tungstenexe/Tungsten-V2/img/Tungsten_V2.JPG

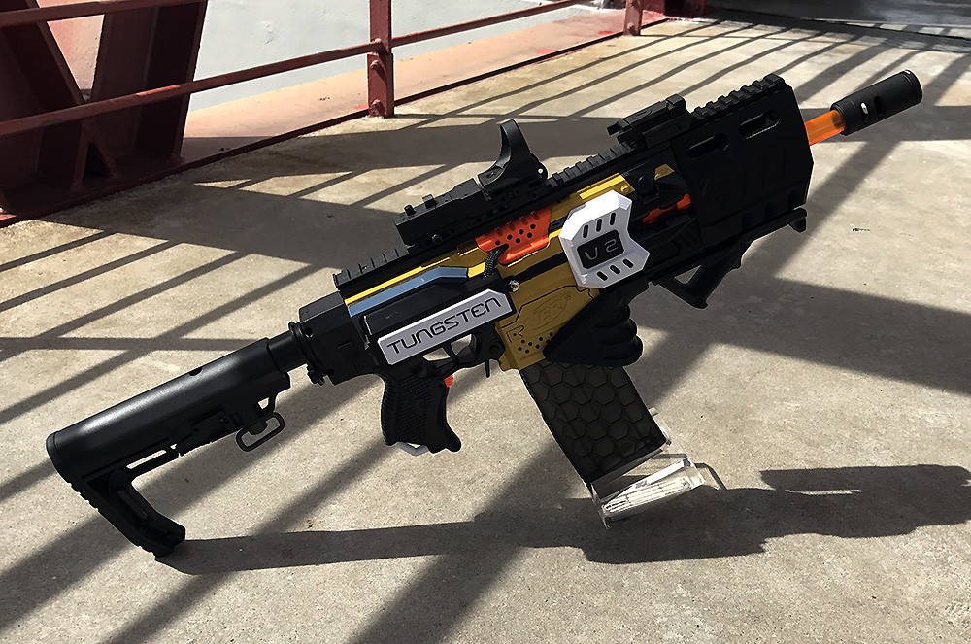
img/Tungsten_V2.JPG
