tungstenexe/Tungsten-V2/circuit/readme.txt

ESC set jumper to have F/B and use Lipo

Disclaimer:
Please note these diagrams are how I implement 
my own blaster built.
 
Do take caution when modding your blaster, 
as I take no responsibility on your modding 
implementation of the circuits shown.
