tungstenexe/Tungsten-V2/ItemsList.docx

Below are the items I made use of for the build, I did not include the normal switches and buttons, wires.

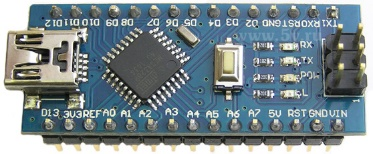
[picture p2: figure]

| Arduino Nano | https://world.taobao.com/item/42296011350.htm?fromSite=main&spm=a312a.7700846.0.0.tO8EAg&_u=81p5mvl5c6fe

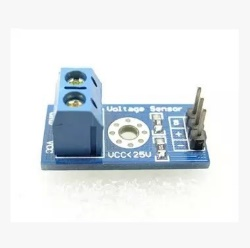
[picture p3: figure]

| Voltage sensor module (to find current voltage of lipo to make calculation of ROF voltage) | https://world.taobao.com/item/43100493066.htm?fromSite=main&spm=a312a.7700846.0.0.tO8EAg&_u=81p5mvl5a29b

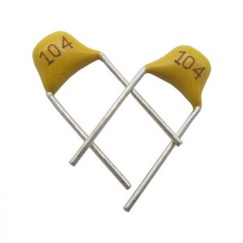
[picture p4: figure]

| 104 Capacitor 104P 0.1UF 100NF 50V (to filter electric noise produced by DC motors) | https://detail.tmall.com/item.htm?id=41231794779&toSite=main

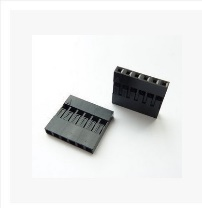
[picture p5: figure]

| DuPont head | https://item.taobao.com/item.htm?spm=a1z0d.6639537.1997196601.117.91b1f81zPnNkX&id=39573216513

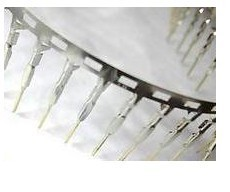
[picture p6: figure]

| DuPont male head | https://world.taobao.com/item/19134756118.htm?fromSite=main&spm=a312a.7700846.0.0.eysEMU&_u=n1p5mvl5d7cb

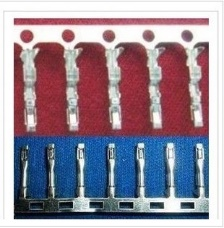
[picture p7: figure]

| DuPont male head | https://world.taobao.com/item/37120521950.htm?fromSite=main&spm=a312a.7700846.0.0.eysEMU&_u=n1p5mvl51604

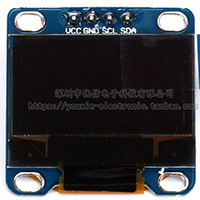
[picture p8: figure]

| Yellow + blue OLED display | https://item.taobao.com/item.htm?spm=a1z09.2.0.0.2ed6e797vXDadE&id=524195193806&_u=51p5mvl5f789

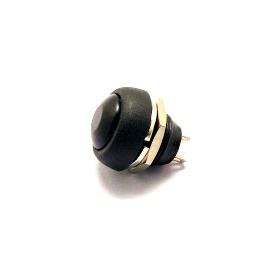
[picture p9: figure]

| Button | https://world.taobao.com/item/537772544456.htm?fromSite=main&spm=a312a.7700846.0.0.eysEMU&_u=n1p5mvl5c95a

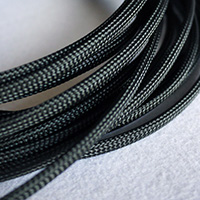
[picture p10: figure]

| Wire net | https://item.taobao.com/item.htm?spm=a1z09.2.0.0.2ed6e7977udndZ&id=546470586881&_u=51p5mvl56b96

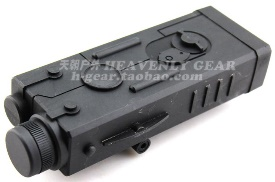
[picture p11: figure]

| Big battery case | https://item.taobao.com/item.htm?spm=a1z09.2.0.0.2ed6e7977udndZ&id=38506953674&_u=51p5mvl5610a

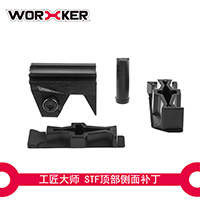
[picture p12: figure]

| Worker cosmetic kit | https://item.taobao.com/item.htm?spm=a1z09.2.0.0.2ed6e797XsdCh0&id=523857592612&_u=61p5mvl5e549
| Worker cosmetic kit | https://item.taobao.com/item.htm?spm=a1z09.2.0.0.2ed6e797XsdCh0&id=40420088470&_u=61p5mvl59a8f

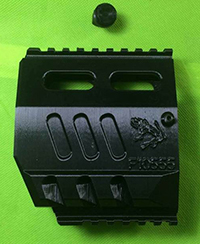
[picture p13: figure]

| Worker cosmetic kit | https://item.taobao.com/item.htm?spm=a1z09.2.0.0.2ed6e797XsdCh0&id=520867765476&_u=61p5mvl5f9ee

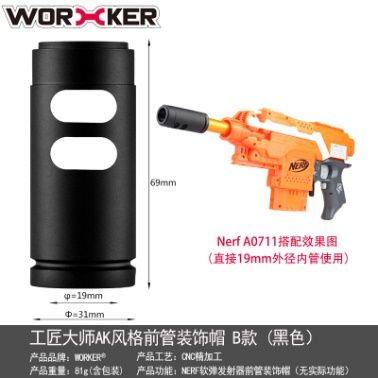
[picture p14: figure]

| Worker cosmetic kit | https://item.taobao.com/item.htm?id=556106349949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 (https://item.taobao.com/item.htm?id=556106349949)

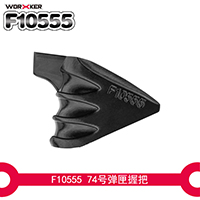
[picture p15: figure]

| Worker cosmetic kit | https://item.taobao.com/item.htm?spm=a1z09.2.0.0.2ed6e797XsdCh0&id=522103785710&_u=61p5mvl5143c

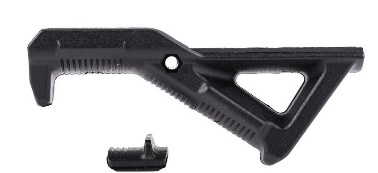
[picture p16: figure]

| Grip | https://item.taobao.com/item.htm?spm=a1z0d.7625083.1998302264.6.7e0ce5fbr6sPRc&id=530326323563

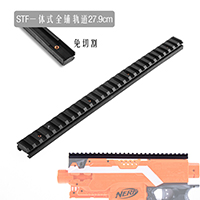
[picture p17: figure]
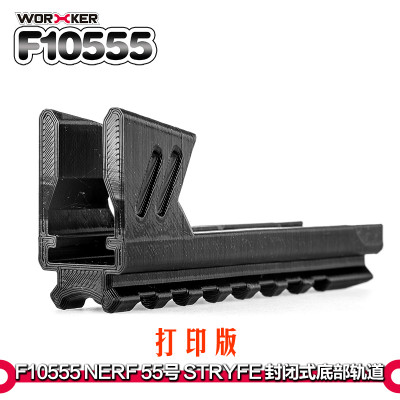
[picture p18: figure]

| Worker cosmetic kit | https://item.taobao.com/item.htm?spm=a1z09.2.0.0.2ed6e797XsdCh0&id=520101702790&_u=61p5mvl5c578

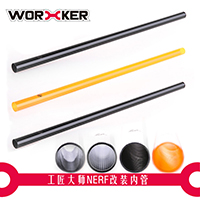
[picture p19: figure]

| 20cm barrel | https://item.taobao.com/item.htm?spm=a1z09.2.0.0.2ed6e797XsdCh0&id=542111980772&_u=61p5mvl55610

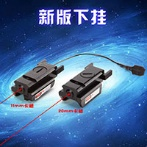
[picture p20: figure]

| | https://item.taobao.com/item.htm?spm=a1z09.2.0.0.2ed6e797XsdCh0&id=523949251644&_u=61p5mvl53e14

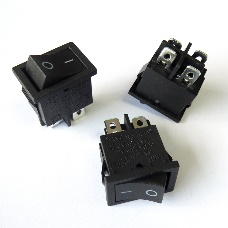
[picture p21: figure]

| 4 legs switch | https://item.taobao.com/item.htm?spm=a1z09.2.0.0.2ed6e797XsdCh0&id=541605000895&_u=61p5mvl5ef70

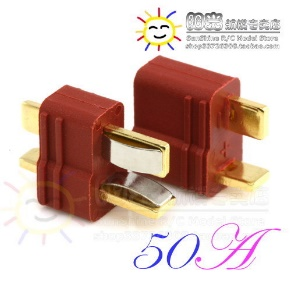
[picture p22: figure]

| Dean connector | https://world.taobao.com/item/2003313604.htm?fromSite=main&spm=a312a.7700846.0.0.eysEMU&_u=n1p5mvl55a26
| Battery Tape | https://hobbyking.com/en_us/battery-tape-150mm-5pcs-bag.html

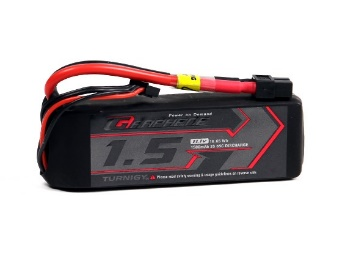
[picture p23: figure]

| Turnigy Graphene 1500mAh 3S 65C LiPo Pack W/ XT60 | https://hobbyking.com/en_us/graphene-1500mah-3s-65c-w-xt60.html

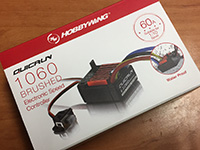
[picture p24: figure]

| Hobbywing 1060 Brushed ESC | Cannot find link

I was unable to locate some of the seller for some items, they seems to have stop selling the items.

There are more basic items such as pin connectors, etc.

Article on Dealing with Motor Noise:

https://www.pololu.com/docs/0J15/9

Other Useful Tools

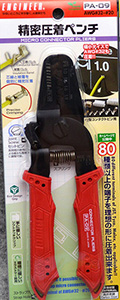
[picture p25: figure]

| Crimper - engineer PA-90 | https://world.taobao.com/item/9117898770.htm?fromSite=main&_u=t2dmg8j26111
