tungstenexe/Tungsten-V2/circuit/00_MainOverall.jpg

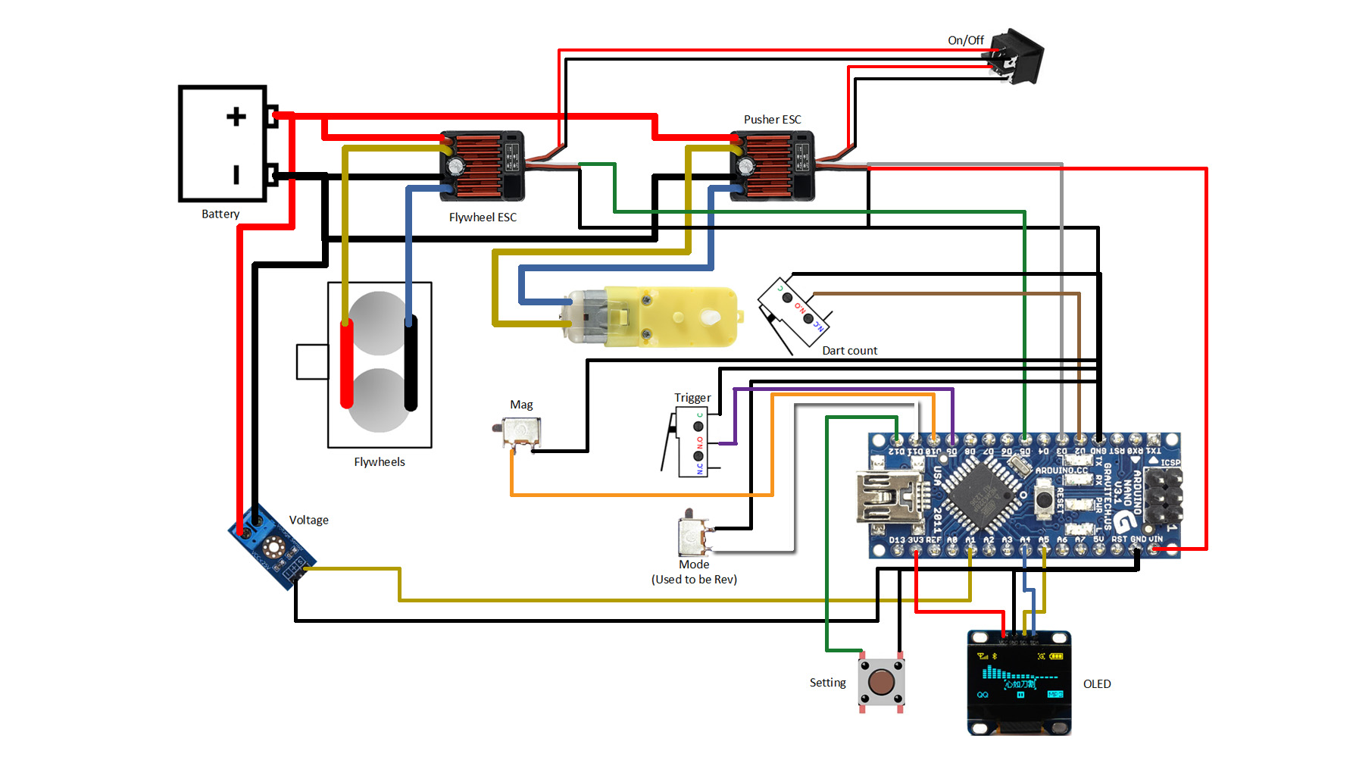
circuit/00_MainOverall.jpg
