tungstenexe/Tungsten-V2/circuit/01_ESC_Battery.jpg

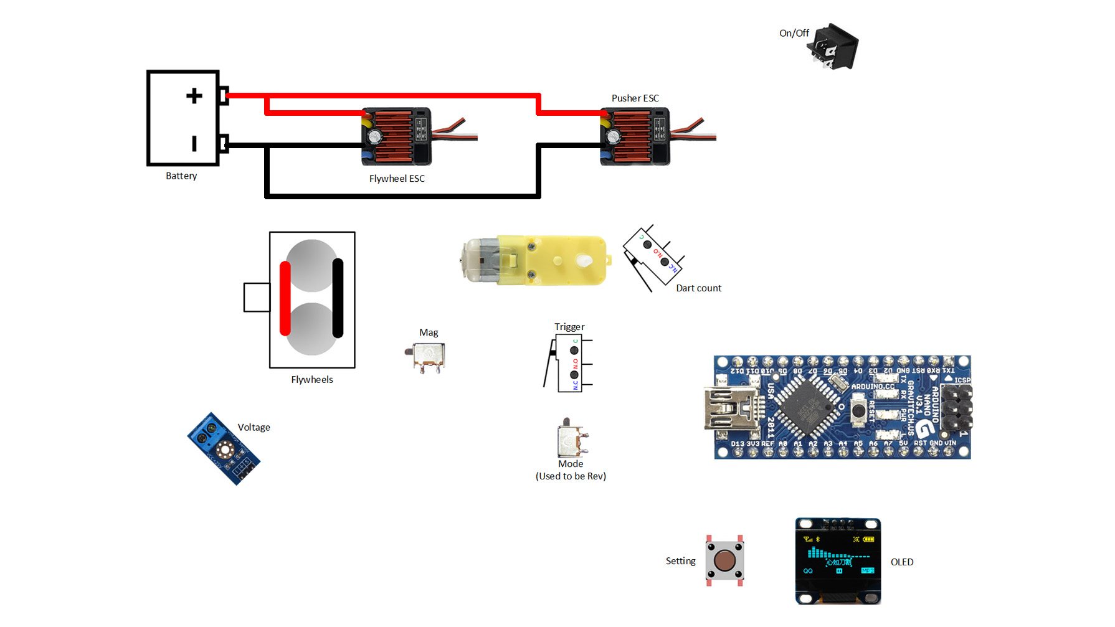
circuit/01_ESC_Battery.jpg
