tungstenexe/Tungsten-V2/circuit/02_ESC_OnOff.jpg

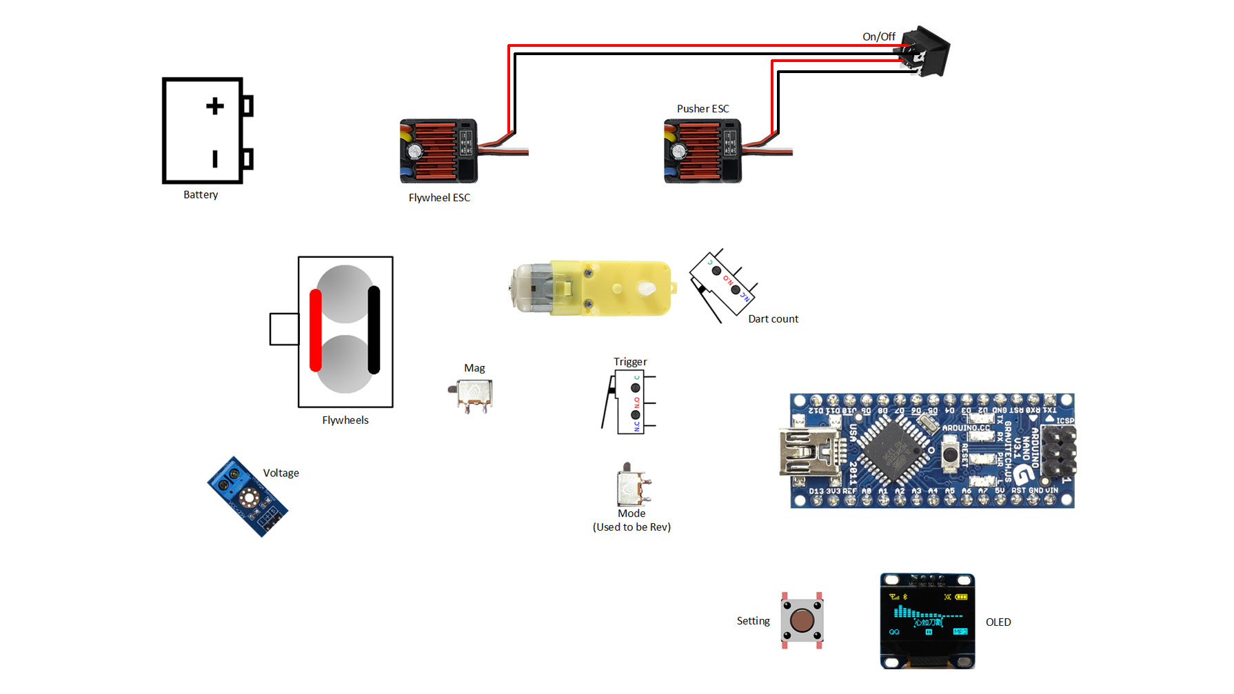
circuit/02_ESC_OnOff.jpg
