tungstenexe/Tungsten-V2/circuit/04_ESC_ControlAndVin.jpg

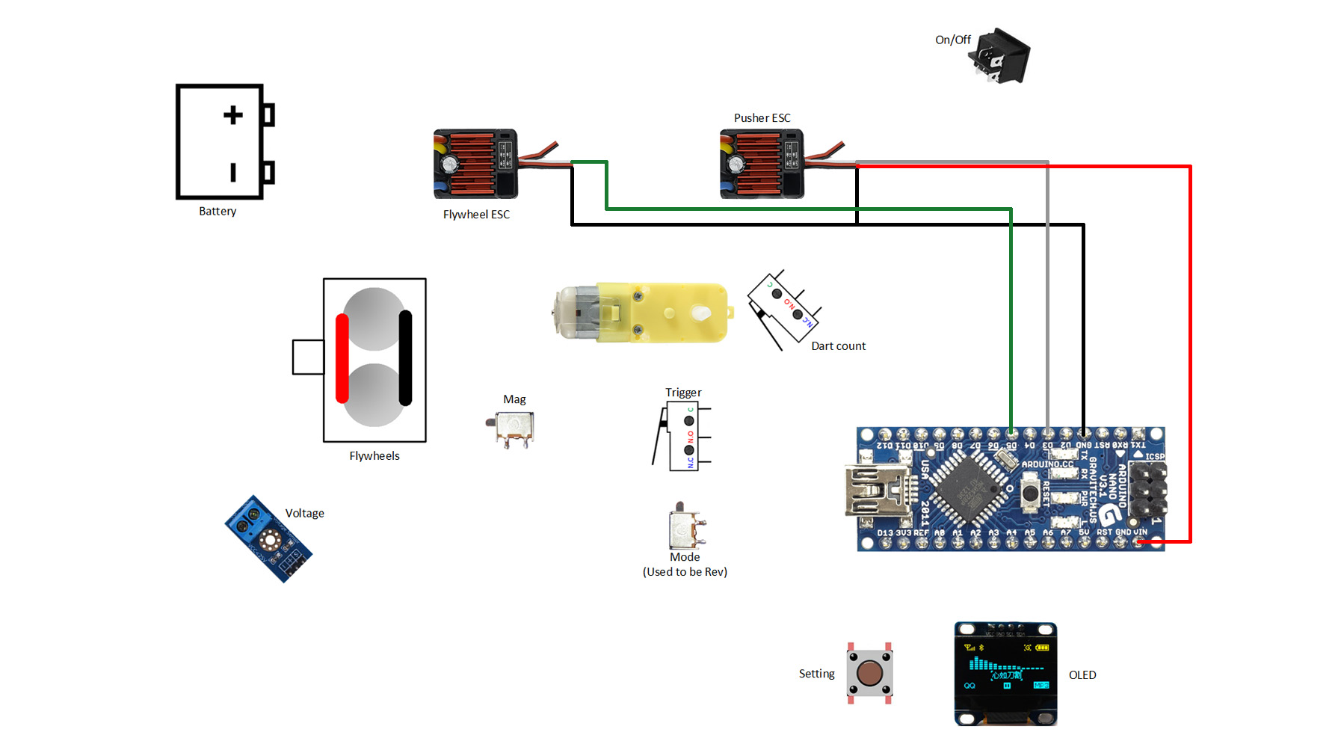
circuit/04_ESC_ControlAndVin.jpg
