tungstenexe/Tungsten-V2/circuit/05_ESC_Overall.jpg

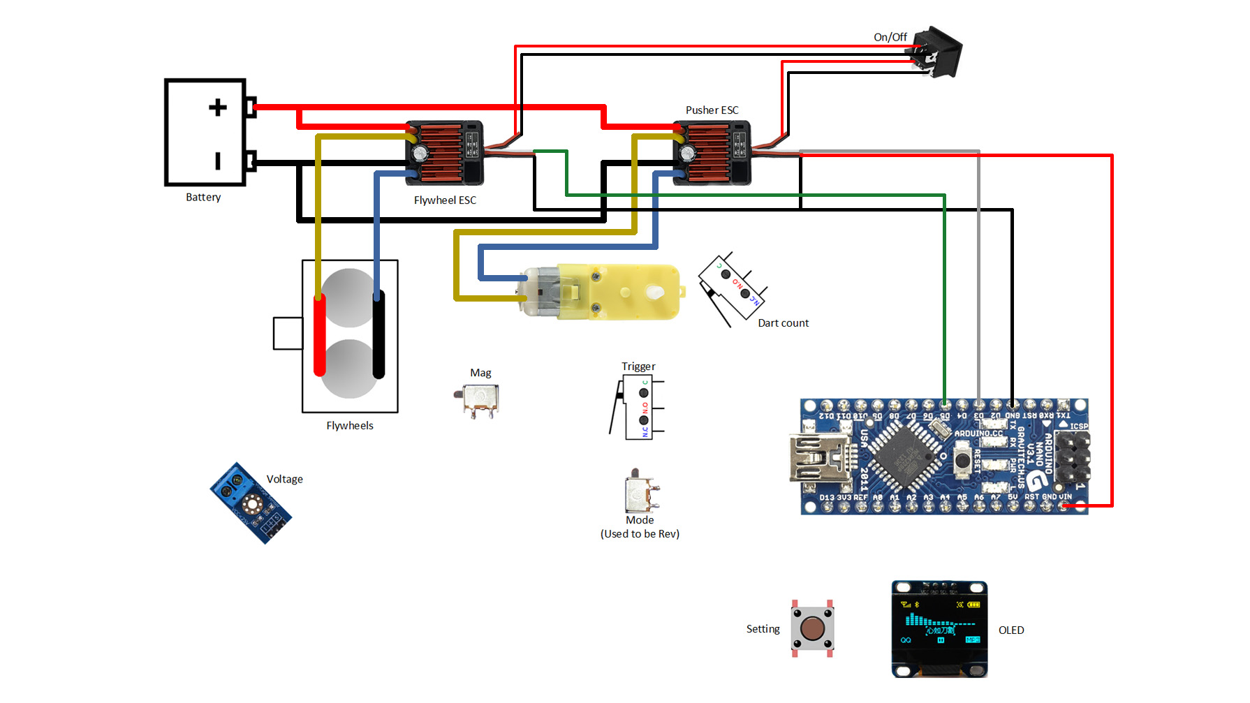
circuit/05_ESC_Overall.jpg
