tungstenexe/Tungsten-V2/circuit/06_VoltageSensor.jpg

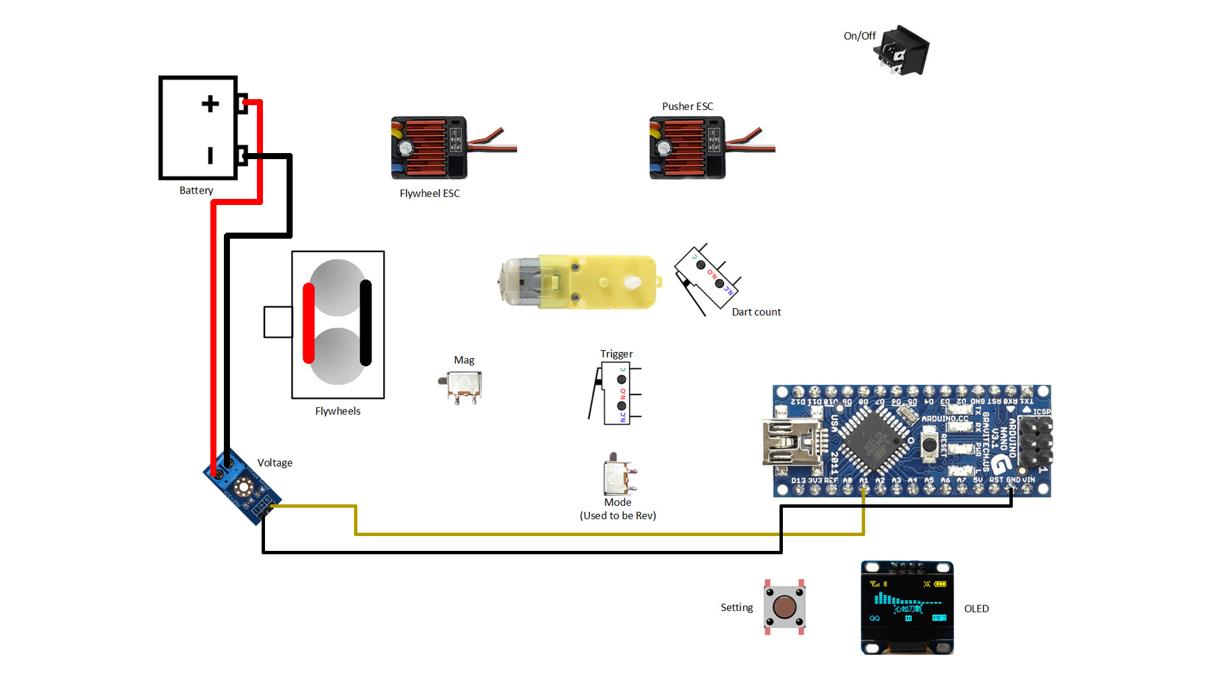
circuit/06_VoltageSensor.jpg
