tungstenexe/Tungsten-V2/circuit/07_DartCounter.jpg

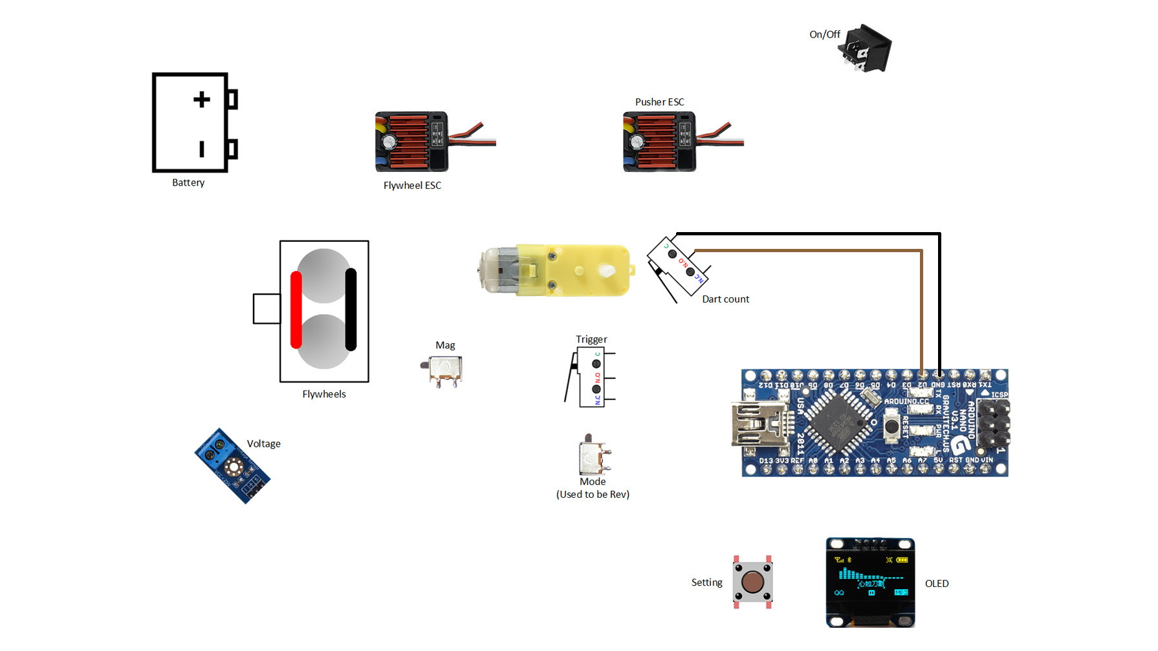
circuit/07_DartCounter.jpg
