tungstenexe/Tungsten-V2/stl/oledButtonHousingPart_B.stl

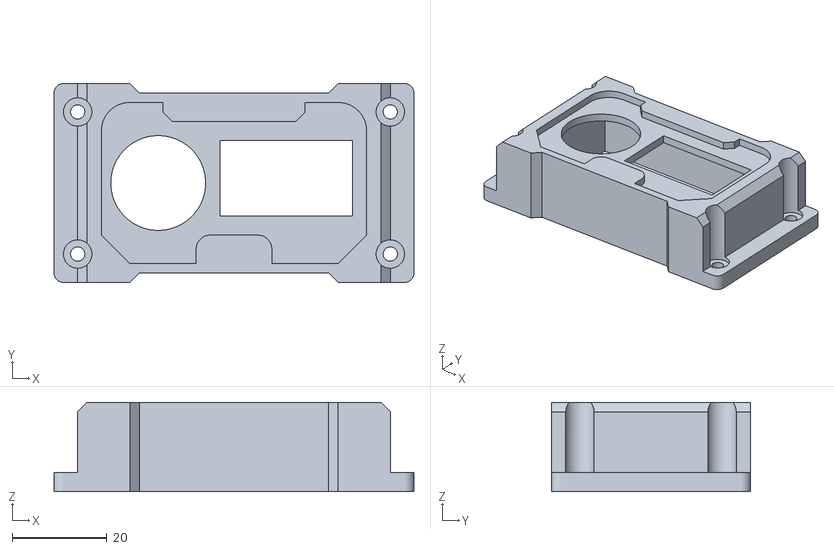
[picture p33: CAD file, 2018-11-21]
stl/oledButtonHousingPart_B.stl
76.0 x 42.0 x 18.9
