tungstenexe/Tungsten-V2/stl/spacerReplace_XSW.stl

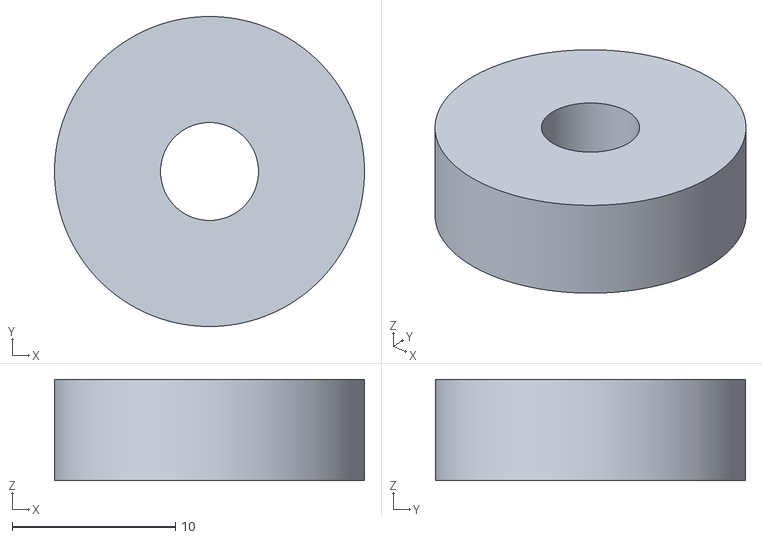
[picture p34: CAD file, 2018-11-21]
stl/spacerReplace_XSW.stl
19.0 x 19.0 x 6.20
