tungstenexe/Tungsten-V2/stl/arduinoHousingPart_A.stl

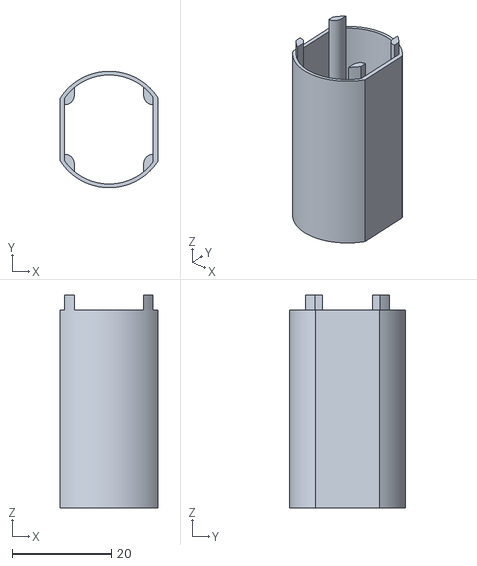
[picture p35: CAD file, 2018-11-21]
stl/arduinoHousingPart_A.stl
19.7 x 23.5 x 43.0
