tungstenexe/Tungsten-V2/stl/arduinoHousingPart_B.stl

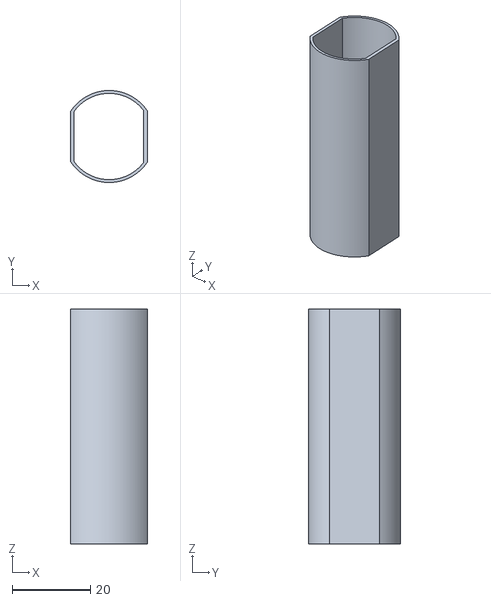
[picture p36: CAD file, 2018-11-21]
stl/arduinoHousingPart_B.stl
19.7 x 23.5 x 60.0
