tungstenexe/Tungsten-V2/stl/oledButtonHousingPart_A.stl

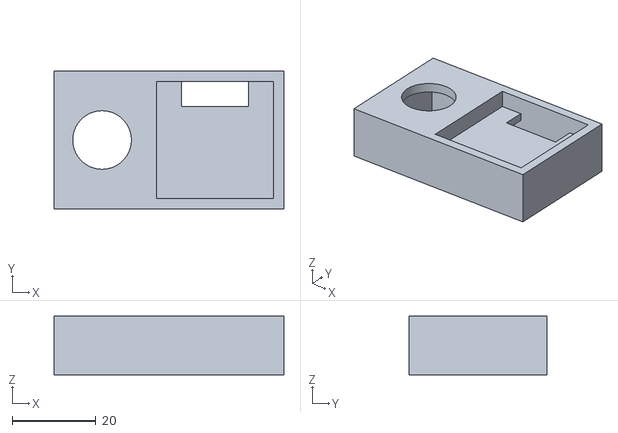
[picture p37: CAD file, 2018-11-21]
stl/oledButtonHousingPart_A.stl
55.0 x 33.0 x 14.0
